TorbanP/lumenpnp/pnp/cad/STEP/x-gantry-back-BodyChamfer010.step

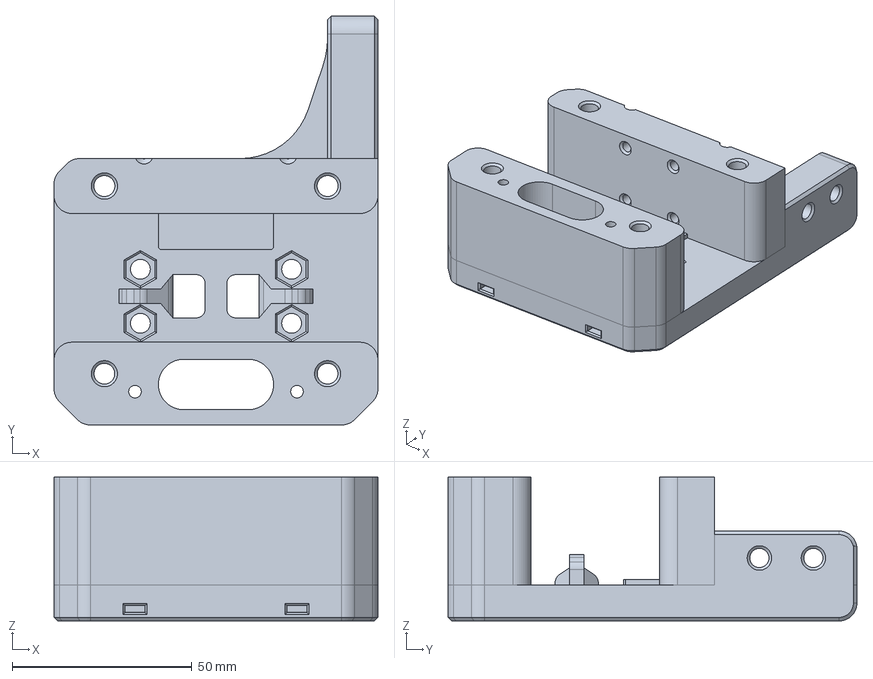
[picture p1: CAD file, 2023-11-08]
pnp/cad/STEP/x-gantry-back-BodyChamfer010.step
90.0 x 113.6 x 40.0 mm
