TorbanP/lumenpnp/pnp/cad/STEP/Feeder Rail.step

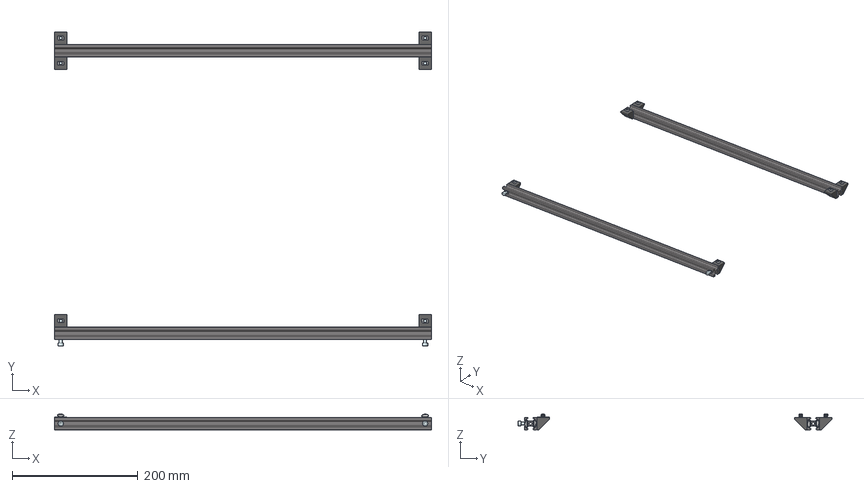
[picture p2: CAD file, 2023-11-08]
pnp/cad/STEP/Feeder Rail.step
600.1 x 500.5 x 25.1 mm
M5x8-Screw227
M5-tslot-nut028 x 2
vslot-extrusion-20mmx20mmx600mm004 x 2
M5x8-Screw186 x 2
M5-tslot-nut026 x 2
M5x8-Screw x 2
M5x8-Screw185 x 2
corner-bracket004 x 2
corner-bracket005 x 2
M5x8-Screw187 x 2
M5-tslot-nut027 x 2
M5-tslot-nut029 x 2
M5-tslot-nut006 x 2
M5-tslot-nut005 x 2
M5x10-Screw337 x 2
M5x10-Screw341 x 2
M5x8-Screw223
M5-tslot-nut019
M5x8-Screw225
corner-bracket003
corner-bracket001
corner-bracket
M5-tslot-nut024
M5-tslot-nut022
M5x8-Screw226
M5x8-Screw222
M5x8-Screw221
M5-tslot-nut025
M5-tslot-nut020
M5-tslot-nut018
corner-bracket002
M5x8-Screw224
M5x8-Screw220
M5-tslot-nut021
M5-tslot-nut023
vslot-extrusion-20mmx20mmx600mm006
