TorbanP/lumenpnp/(list of files, cad)

Other CAD files:
pnp/cad/STEP/Drag Chain/Drag Chain.iam
pnp/cad/STEP/Drag Chain/M5-Nut660.ipt
pnp/cad/STEP/Drag Chain/M5-Nut661.ipt
pnp/cad/STEP/Drag Chain/M5x10-Screw364.ipt
pnp/cad/STEP/Drag Chain/M5x10-Screw365.ipt
pnp/cad/STEP/Drag Chain/M5x16-Screw247.ipt
pnp/cad/STEP/Drag Chain/M5x16-Screw248.ipt
pnp/cad/STEP/Drag Chain/M5x25-Screw.ipt
pnp/cad/STEP/Drag Chain/drag-chain-asm.ipt
pnp/cad/STEP/Drag Chain/front-drag-chain-mount.ipt
pnp/cad/STEP/Drag Chain/x-cable-chain-bracket.ipt
pnp/cad/STEP/Feeder Rail/Feeder Rail.iam
pnp/cad/STEP/Feeder Rail/Front-Feeder-Rail.iam
pnp/cad/STEP/Feeder Rail/M5-tslot-nut005.ipt
pnp/cad/STEP/Feeder Rail/M5-tslot-nut006.ipt
pnp/cad/STEP/Feeder Rail/M5-tslot-nut018.ipt
pnp/cad/STEP/Feeder Rail/M5-tslot-nut019.ipt
pnp/cad/STEP/Feeder Rail/M5-tslot-nut020.ipt
pnp/cad/STEP/Feeder Rail/M5-tslot-nut021.ipt
pnp/cad/STEP/Feeder Rail/M5-tslot-nut022.ipt
pnp/cad/STEP/Feeder Rail/M5-tslot-nut023.ipt
pnp/cad/STEP/Feeder Rail/M5-tslot-nut024.ipt
pnp/cad/STEP/Feeder Rail/M5-tslot-nut025.ipt
pnp/cad/STEP/Feeder Rail/M5-tslot-nut026.ipt
pnp/cad/STEP/Feeder Rail/M5-tslot-nut027.ipt
pnp/cad/STEP/Feeder Rail/M5-tslot-nut028.ipt
pnp/cad/STEP/Feeder Rail/M5-tslot-nut029.ipt
pnp/cad/STEP/Feeder Rail/M5x10-Screw337.ipt
pnp/cad/STEP/Feeder Rail/M5x10-Screw341.ipt
pnp/cad/STEP/Feeder Rail/M5x8-Screw.ipt
pnp/cad/STEP/Feeder Rail/M5x8-Screw185.ipt
pnp/cad/STEP/Feeder Rail/M5x8-Screw186.ipt
pnp/cad/STEP/Feeder Rail/M5x8-Screw187.ipt
pnp/cad/STEP/Feeder Rail/M5x8-Screw220.ipt
pnp/cad/STEP/Feeder Rail/M5x8-Screw221.ipt
pnp/cad/STEP/Feeder Rail/M5x8-Screw222.ipt
pnp/cad/STEP/Feeder Rail/M5x8-Screw223.ipt
pnp/cad/STEP/Feeder Rail/M5x8-Screw224.ipt
pnp/cad/STEP/Feeder Rail/M5x8-Screw225.ipt
pnp/cad/STEP/Feeder Rail/M5x8-Screw226.ipt
pnp/cad/STEP/Feeder Rail/M5x8-Screw227.ipt
pnp/cad/STEP/Feeder Rail/corner-bracket.ipt
pnp/cad/STEP/Feeder Rail/corner-bracket001.ipt
pnp/cad/STEP/Feeder Rail/corner-bracket002.ipt
pnp/cad/STEP/Feeder Rail/corner-bracket003.ipt
pnp/cad/STEP/Feeder Rail/corner-bracket004.ipt
pnp/cad/STEP/Feeder Rail/corner-bracket005.ipt
pnp/cad/STEP/Feeder Rail/vslot-extrusion-20mmx20mmx600mm004.ipt
pnp/cad/STEP/Feeder Rail/vslot-extrusion-20mmx20mmx600mm006.ipt
pnp/cad/STEP/Staging Plate/Auxiliary-Staging-Plate.iam
pnp/cad/STEP/Staging Plate/M2.5x8-Screw197.ipt
pnp/cad/STEP/Staging Plate/M2.5x8-Screw198.ipt
pnp/cad/STEP/Staging Plate/M2.5x8-Screw199.ipt
pnp/cad/STEP/Staging Plate/M2.5x8-Screw200.ipt
pnp/cad/STEP/Staging Plate/M3-Nut543.ipt
pnp/cad/STEP/Staging Plate/M3-Nut544.ipt
pnp/cad/STEP/Staging Plate/M3-Nut545.ipt
pnp/cad/STEP/Staging Plate/M3-Nut546.ipt
pnp/cad/STEP/Staging Plate/M3-Nut551.ipt
pnp/cad/STEP/Staging Plate/M3-Nut552.ipt
pnp/cad/STEP/Staging Plate/M3-Nut553.ipt
pnp/cad/STEP/Staging Plate/M3-Nut554.ipt
pnp/cad/STEP/Staging Plate/M3-Nut556.ipt
pnp/cad/STEP/Staging Plate/M3-Nut557.ipt
pnp/cad/STEP/Staging Plate/M3-Nut558.ipt
pnp/cad/STEP/Staging Plate/M3-Nut560.ipt
pnp/cad/STEP/Staging Plate/M3-Nut561.ipt
pnp/cad/STEP/Staging Plate/M3-Nut565.ipt
pnp/cad/STEP/Staging Plate/M3-Nut566.ipt
pnp/cad/STEP/Staging Plate/M3-Nut567.ipt
pnp/cad/STEP/Staging Plate/M3-Nut568.ipt
pnp/cad/STEP/Staging Plate/M3-Nut580.ipt
pnp/cad/STEP/Staging Plate/M3-Nut581.ipt
pnp/cad/STEP/Staging Plate/M3-Nut582.ipt
pnp/cad/STEP/Staging Plate/M3-Nut583.ipt
pnp/cad/STEP/Staging Plate/M3-Nut584.ipt
pnp/cad/STEP/Staging Plate/M3-Nut585.ipt
pnp/cad/STEP/Staging Plate/M3-Nut594.ipt
pnp/cad/STEP/Staging Plate/M3-Nut675.ipt
pnp/cad/STEP/Staging Plate/M3-Nut807.ipt
pnp/cad/STEP/Staging Plate/M3-Nut808.ipt
pnp/cad/STEP/Staging Plate/M3x10-Screw.ipt
pnp/cad/STEP/Staging Plate/M3x10-Screw114.ipt
pnp/cad/STEP/Staging Plate/M3x10-Screw115.ipt
pnp/cad/STEP/Staging Plate/M3x10-Screw116.ipt
pnp/cad/STEP/Staging Plate/M3x10-Screw117.ipt
pnp/cad/STEP/Staging Plate/M3x10-Screw118.ipt
pnp/cad/STEP/Staging Plate/M3x10-Screw119.ipt
pnp/cad/STEP/Staging Plate/M3x10-Screw120.ipt
pnp/cad/STEP/Staging Plate/M3x10-Screw121.ipt
pnp/cad/STEP/Staging Plate/M3x10-Screw122.ipt
pnp/cad/STEP/Staging Plate/M3x10-Screw123.ipt
pnp/cad/STEP/Staging Plate/M3x10-Screw124.ipt
pnp/cad/STEP/Staging Plate/M3x10-Screw127.ipt
pnp/cad/STEP/Staging Plate/M3x10-Screw129.ipt
pnp/cad/STEP/Staging Plate/M3x14-Screw187.ipt
pnp/cad/STEP/Staging Plate/M3x14-Screw188.ipt
pnp/cad/STEP/Staging Plate/M3x14-Screw189.ipt
pnp/cad/STEP/Staging Plate/M3x14-Screw190.ipt
pnp/cad/STEP/Staging Plate/M3x14-Screw191.ipt
pnp/cad/STEP/Staging Plate/M3x14-Screw192.ipt
pnp/cad/STEP/Staging Plate/M3x14-Screw193.ipt
pnp/cad/STEP/Staging Plate/M3x16-Screw098.ipt
pnp/cad/STEP/Staging Plate/M3x16-Screw099.ipt
pnp/cad/STEP/Staging Plate/M3x16-Screw100.ipt
pnp/cad/STEP/Staging Plate/M3x16-Screw101.ipt
pnp/cad/STEP/Staging Plate/M3x16-Screw102.ipt
pnp/cad/STEP/Staging Plate/M3x16-Screw103.ipt
pnp/cad/STEP/Staging Plate/M3x16-Screw104.ipt
pnp/cad/STEP/Staging Plate/M3x16-Screw105.ipt
pnp/cad/STEP/Staging Plate/M3x30-Screw169.ipt
pnp/cad/STEP/Staging Plate/M3x30-Screw170.ipt
pnp/cad/STEP/Staging Plate/M3x30-Screw171.ipt
pnp/cad/STEP/Staging Plate/M3x5.5x25-Spacer.ipt
pnp/cad/STEP/Staging Plate/M3x5.5x25-Spacer004.ipt
pnp/cad/STEP/Staging Plate/M3x5.5x25-Spacer005.ipt
pnp/cad/STEP/Staging Plate/M3x5.5x25-Spacer006.ipt
pnp/cad/STEP/Staging Plate/M3x8-Screw541.ipt
pnp/cad/STEP/Staging Plate/M3x8-Screw542.ipt
pnp/cad/STEP/Staging Plate/M3x8-Screw543.ipt
pnp/cad/STEP/Staging Plate/M3x8-Screw544.ipt
pnp/cad/STEP/Staging Plate/M3x8-Screw545.ipt
pnp/cad/STEP/Staging Plate/M3x8-Screw546.ipt
pnp/cad/STEP/Staging Plate/M3x8-Screw547.ipt
pnp/cad/STEP/Staging Plate/M5-tslot-nut030.ipt
pnp/cad/STEP/Staging Plate/M5-tslot-nut031.ipt
pnp/cad/STEP/Staging Plate/M5-tslot-nut032.ipt
pnp/cad/STEP/Staging Plate/M5-tslot-nut033.ipt
pnp/cad/STEP/Staging Plate/M5-tslot-nut036.ipt
pnp/cad/STEP/Staging Plate/M5-tslot-nut037.ipt
pnp/cad/STEP/Staging Plate/M5-tslot-nut038.ipt
pnp/cad/STEP/Staging Plate/M5-tslot-nut039.ipt
pnp/cad/STEP/Staging Plate/M5x8-Screw228.ipt
pnp/cad/STEP/Staging Plate/M5x8-Screw229.ipt
pnp/cad/STEP/Staging Plate/M5x8-Screw230.ipt
pnp/cad/STEP/Staging Plate/M5x8-Screw231.ipt
pnp/cad/STEP/Staging Plate/M5x8-Screw232.ipt
pnp/cad/STEP/Staging Plate/M5x8-Screw233.ipt
pnp/cad/STEP/Staging Plate/M5x8-Screw234.ipt
pnp/cad/STEP/Staging Plate/M5x8-Screw235.ipt
pnp/cad/STEP/Staging Plate/Support-Foot.iam
pnp/cad/STEP/Staging Plate/Valves.iam
pnp/cad/STEP/Staging Plate/aux-staging-plate-foot.ipt
pnp/cad/STEP/Staging Plate/bottom-camera-cover.ipt
pnp/cad/STEP/Staging Plate/bottom-camera-mount.ipt
pnp/cad/STEP/Staging Plate/bottom-light-mount.ipt
pnp/cad/STEP/Staging Plate/bottom-ring-light.ipt
pnp/cad/STEP/Staging Plate/datum-board-mount.ipt
pnp/cad/STEP/Staging Plate/datum-board.ipt
pnp/cad/STEP/Staging Plate/mobo-bottom-cover.ipt
pnp/cad/STEP/Staging Plate/mobo-top-cover001.ipt
pnp/cad/STEP/Staging Plate/nozzle-rack.ipt
pnp/cad/STEP/Staging Plate/peek-cable-clamp.ipt
pnp/cad/STEP/Staging Plate/peek-cable-clamp001.ipt
pnp/cad/STEP/Staging Plate/peek-cable-clamp002.ipt
pnp/cad/STEP/Staging Plate/peek-cable-clamp003.ipt
pnp/cad/STEP/Staging Plate/peek-cable-clamp004.ipt
pnp/cad/STEP/Staging Plate/peek-cable-clamp005.ipt
pnp/cad/STEP/Staging Plate/pneumatic-y-adapter001.ipt
pnp/cad/STEP/Staging Plate/pneumatic-y-adapter002.ipt
pnp/cad/STEP/Staging Plate/pump-mount.ipt
pnp/cad/STEP/Staging Plate/pump-mount001.ipt
pnp/cad/STEP/Staging Plate/solenoid-valve.ipt
pnp/cad/STEP/Staging Plate/solenoid-valve001.ipt
pnp/cad/STEP/Staging Plate/staging-plate.ipt
pnp/cad/STEP/Staging Plate/staging-plate1.ipt
pnp/cad/STEP/Staging Plate/static-camera-foot.ipt
pnp/cad/STEP/Staging Plate/usb-camera-lower.ipt
pnp/cad/STEP/Staging Plate/vacuum-pump.ipt
pnp/cad/STEP/Staging Plate/vacuum-pump001.ipt
pnp/cad/STEP/Staging Plate/valve-mount.ipt
pnp/cad/STEP/Staging Plate/y-coupler-bracket.ipt
pnp/cad/STEP/X-Gantry Back/525mm-MGN12H.ipt
pnp/cad/STEP/X-Gantry Back/Array004.iam
pnp/cad/STEP/X-Gantry Back/CameraAndLight.iam
pnp/cad/STEP/X-Gantry Back/GT2-idler005.ipt
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
