TorbanP/lumenpnp/pnp/pcb/mobo/dual_motors.kicad_sch

## KiCad design pnp/pcb/mobo/dual_motors.kicad_sch (2023-09-23)

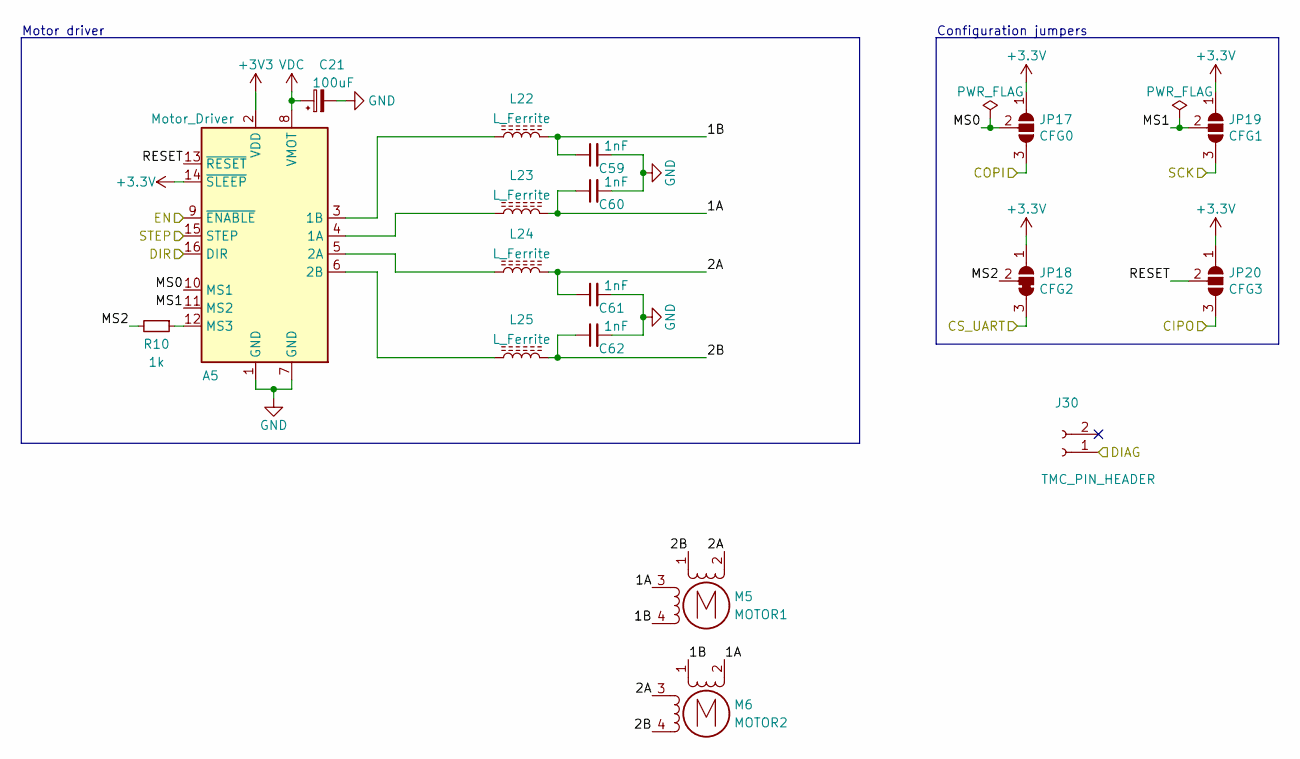
[picture p4: schematic dual_motors.kicad_sch]

Parts:
A5: Motor_Driver; Pololu_Breakout-16_15.2x20.3mm; Digikey 1460-TMC2209SILENTSTEPSTICK-ND
C21: 100uF; CP_Elec_6.3x7.7; Digikey 493-2203-1-ND
C59, C60, C61, C62: 1nF; C_0805_2012Metric; Digikey 1276-1020-1-ND
J30: TMC_PIN_HEADER; PinSocket_1x02_P2.54mm_Vertical; LCSC C49661
JP17: CFG0; SolderJumper-3_P1.3mm_Open_RoundedPad1.0x1.5mm; LCSC DNP
JP18: CFG2; SolderJumper-3_P1.3mm_Bridged23_RoundedPad1.0x1.5mm; LCSC DNP
JP19: CFG1; SolderJumper-3_P1.3mm_Open_RoundedPad1.0x1.5mm; LCSC DNP
JP20: CFG3; SolderJumper-3_P1.3mm_Open_RoundedPad1.0x1.5mm; LCSC DNP
L22, L23, L24, L25: L_Ferrite; L_0805_2012Metric; Digikey 1934-1472-1-ND
M5: MOTOR1; JST_XH_B4B-XH-A_1x04_P2.50mm_Vertical; LCSC C37815
M6: MOTOR2; JST_XH_B4B-XH-A_1x04_P2.50mm_Vertical; LCSC C37815
R10: 1k; R_0805_2012Metric; JLCPCB C17513

Connections:
1A: C60.1, L23.2, M5.3, M6.2 (-)
1B: C59.1, L22.2, M5.4, M6.1
2A: C61.1, L24.2, M5.2 (-), M6.3
2B: C62.1, L25.2, M5.1, M6.4
+3.3V: A5.14 (~SLEEP), JP17.1 (A), JP18.1 (B), JP19.1 (A), JP20.1 (A)
+3V3: A5.2 (VDD)
CIPO: JP20.3 (B)
COPI: JP17.3 (B)
CS_UART: JP18.3 (A)
DIAG: J30.1
DIR: A5.16 (DIR)
EN: A5.9 (~ENABLE)
GND: A5.1 (GND), A5.7 (GND), C21.2, C59.2, C60.2, C61.2, C62.2
MS0: A5.10 (MS1), JP17.2 (C)
MS1: A5.11 (MS2), JP19.2 (C)
MS2: JP18.2 (C), R10.2
unnamed: A5.3 (1B), L22.1
unnamed: A5.4 (1A), L23.1
unnamed: A5.5 (2A), L24.1
unnamed: A5.6 (2B), L25.1
unnamed: A5.12 (MS3), R10.1
RESET: A5.13 (~RESET), JP20.2 (C)
SCK: JP19.3 (B)
STEP: A5.15 (STEP)
VDC: A5.8 (VMOT), C21.1

Notes on the sheet:
Configuration jumpers
Motor driver
