TorbanP/lumenpnp/pnp/pcb/mobo/limit_switches.kicad_sch

## KiCad design pnp/pcb/mobo/limit_switches.kicad_sch (2023-09-23)

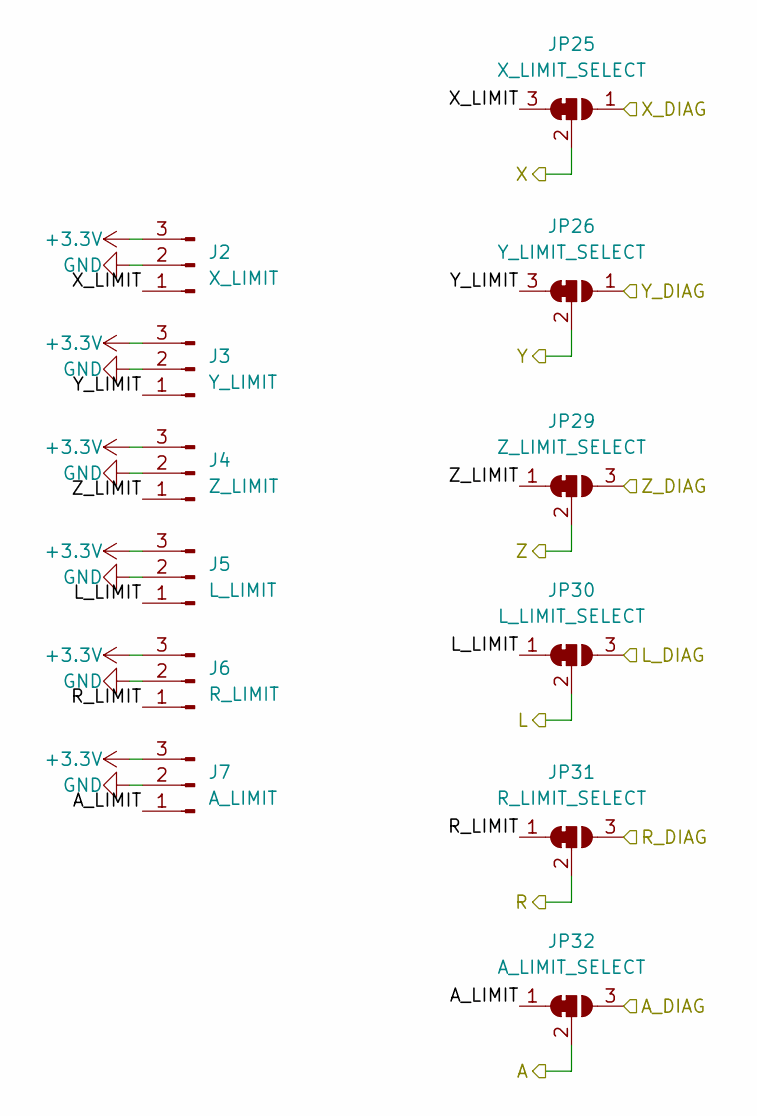
[picture p5: schematic limit_switches.kicad_sch]

Parts:
J2: X_LIMIT; JST_XH_B3B-XH-A_1x03_P2.50mm_Vertical; LCSC C2316
J3: Y_LIMIT; JST_XH_B3B-XH-A_1x03_P2.50mm_Vertical; LCSC C2316
J4: Z_LIMIT; JST_XH_B3B-XH-A_1x03_P2.50mm_Vertical; LCSC C2316
J5: L_LIMIT; JST_XH_B3B-XH-A_1x03_P2.50mm_Vertical; LCSC C2316
J6: R_LIMIT; JST_XH_B3B-XH-A_1x03_P2.50mm_Vertical; LCSC C2316
J7: A_LIMIT; JST_XH_B3B-XH-A_1x03_P2.50mm_Vertical; LCSC C2316
JP25: X_LIMIT_SELECT; SolderJumper-3_P1.3mm_Bridged12_RoundedPad1.0x1.5mm; LCSC DNP
JP26: Y_LIMIT_SELECT; SolderJumper-3_P1.3mm_Bridged12_RoundedPad1.0x1.5mm; LCSC DNP
JP29: Z_LIMIT_SELECT; SolderJumper-3_P1.3mm_Bridged12_RoundedPad1.0x1.5mm; LCSC DNP
JP30: L_LIMIT_SELECT; SolderJumper-3_P1.3mm_Bridged12_RoundedPad1.0x1.5mm; LCSC DNP
JP31: R_LIMIT_SELECT; SolderJumper-3_P1.3mm_Bridged12_RoundedPad1.0x1.5mm; LCSC DNP
JP32: A_LIMIT_SELECT; SolderJumper-3_P1.3mm_Bridged12_RoundedPad1.0x1.5mm; LCSC DNP

Connections:
+3.3V: J2.3, J3.3, J4.3, J5.3, J6.3, J7.3
A: JP32.2 (C)
A_DIAG: JP32.3 (B)
A_LIMIT: J7.1, JP32.1 (A)
GND: J2.2, J3.2, J4.2, J5.2, J6.2, J7.2
L: JP30.2 (C)
L_DIAG: JP30.3 (B)
L_LIMIT: J5.1, JP30.1 (A)
R: JP31.2 (C)
R_DIAG: JP31.3 (B)
R_LIMIT: J6.1, JP31.1 (A)
X: JP25.2 (C)
X_DIAG: JP25.1 (B)
X_LIMIT: J2.1, JP25.3 (A)
Y: JP26.2 (C)
Y_DIAG: JP26.1 (B)
Y_LIMIT: J3.1, JP26.3 (A)
Z: JP29.2 (C)
Z_DIAG: JP29.3 (B)
Z_LIMIT: J4.1, JP29.1 (A)
