TorbanP/lumenpnp/pnp/pcb/mobo/servos.kicad_sch

## KiCad design pnp/pcb/mobo/servos.kicad_sch (2023-09-23)

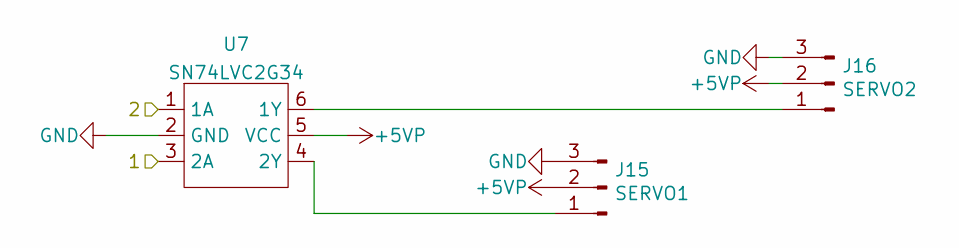
[picture p10: schematic servos.kicad_sch]

Parts:
J15: SERVO1; JST_XH_B3B-XH-A_1x03_P2.50mm_Vertical; LCSC C2316
J16: SERVO2; JST_XH_B3B-XH-A_1x03_P2.50mm_Vertical; LCSC C2316
U7: SN74LVC2G34; SOT-23-6; Digikey SN74LVC2G34DBVR

Connections:
1: U7.3 (2A)
2: U7.1 (1A)
+5VP: J15.2, J16.2, U7.5 (VCC)
GND: J15.3, J16.3, U7.2 (GND)
unnamed: J15.1, U7.4 (2Y)
unnamed: J16.1, U7.6 (1Y)
