TorbanP/lumenpnp/pnp/pcb/mobo/usb.kicad_sch

## KiCad design pnp/pcb/mobo/usb.kicad_sch (2023-09-23)

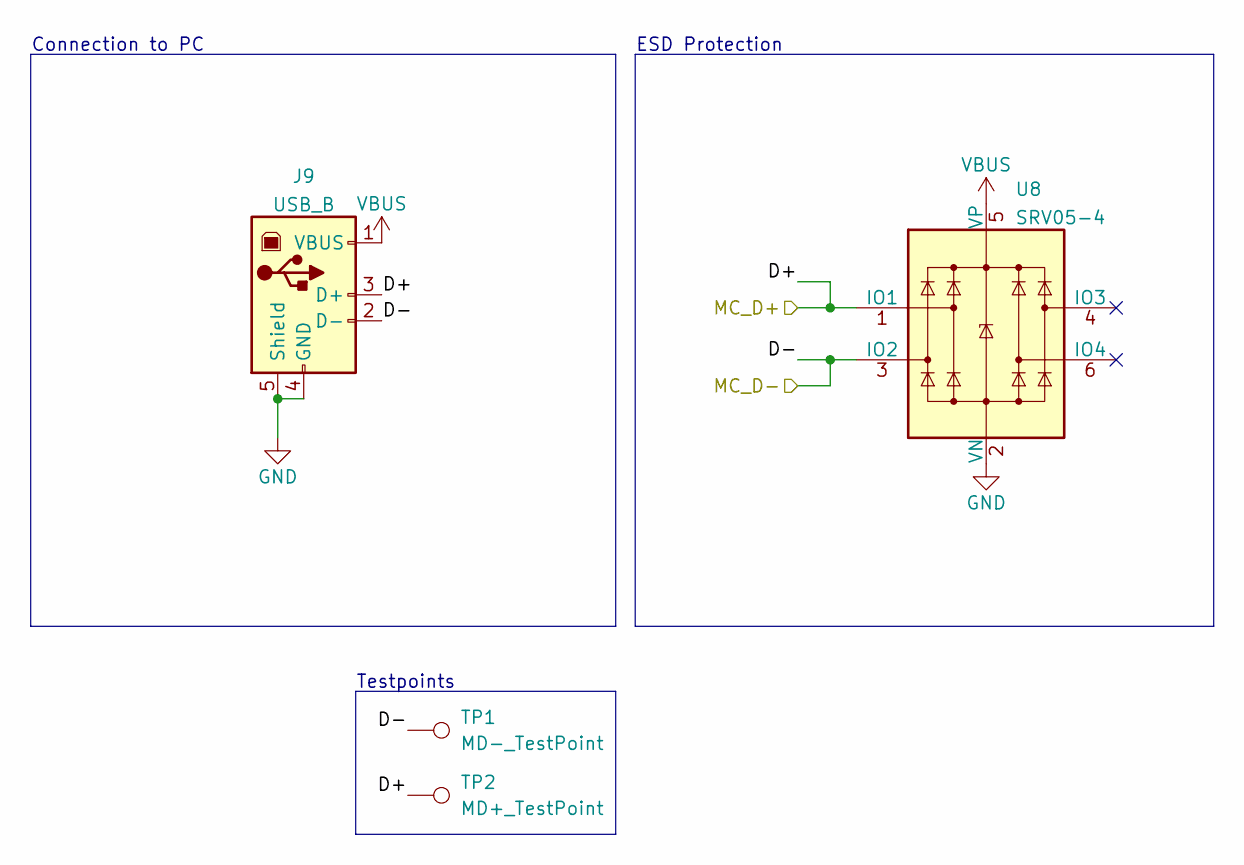
[picture p12: schematic usb.kicad_sch]

Parts:
J9: USB_B; USB_B_Lumberg_2411_02_Horizontal; Digikey SS-52300-001
TP1: MD-_TestPoint; TestPoint_Pad_D2.0mm; LCSC DNP
TP2: MD+_TestPoint; TestPoint_Pad_D2.0mm; LCSC DNP
U8: SRV05-4; SOT-23-6; Digikey 4617-SRV05-4TR-ND

Connections:
D+: J9.3 (D+), TP2.1, U8.1 (IO1)
D-: J9.2 (D-), TP1.1, U8.3 (IO2)
GND: J9.4 (GND), J9.5 (Shield), U8.2 (VN)
VBUS: J9.1 (VBUS), U8.5 (VP)

Notes on the sheet:
ESD Protection
Testpoints
Connection to PC
