TorbanP/lumenpnp/pnp/pcb/mobo/vacuum_sensors.kicad_sch

## KiCad design pnp/pcb/mobo/vacuum_sensors.kicad_sch (2023-09-23)

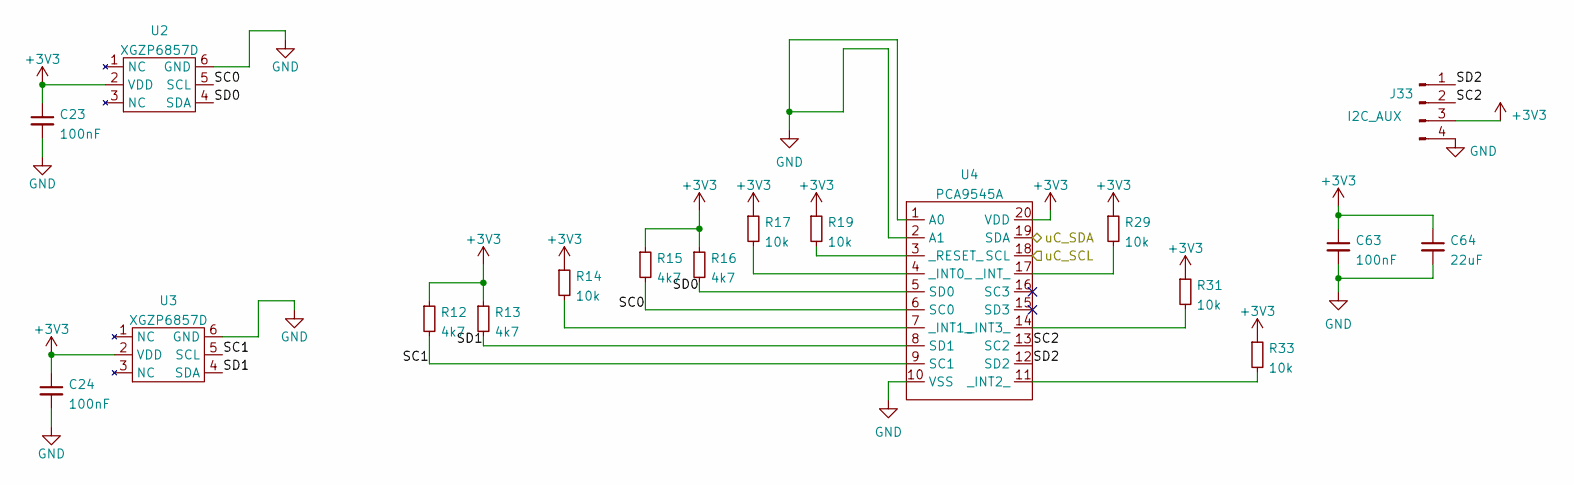
[picture p13: schematic vacuum_sensors.kicad_sch]

Parts:
C23, C24, C63: 100nF; C_0805_2012Metric; Digikey 1276-1180-1-ND
C64: 22uF; C_0805_2012Metric; JLCPCB C45783
J33: I2C_AUX; PinHeader_1x04_P2.54mm_Vertical; LCSC C2691448
R12, R13, R15, R16: 4k7; R_0805_2012Metric; Digikey A129757CT-ND
R14, R17, R19, R29, R31, R33: 10k; R_0805_2012Metric; Digikey RMCF0805FT10K0CT-ND
U2, U3: XGZP6857D; LCSC DNP
U4: PCA9545A; TSSOP-20_4.4x6.5mm_P0.65mm; Digikey 568-1865-1-ND

Connections:
+3V3: C23.1, C24.1, C63.1, C64.1, J33.3, R12.1, R13.1, R14.1, R15.1, R16.1, R17.1, R19.1, R29.1, R31.1, R33.1, U2.2 (VDD), U3.2 (VDD), U4.20 (VDD)
GND: C23.2, C24.2, C63.2, C64.2, J33.4, U2.6 (GND), U3.6 (GND), U4.1 (A0), U4.2 (A1), U4.10 (VSS)
unnamed: R14.2, U4.7 (_INT1_)
unnamed: R17.2, U4.4 (_INT0_)
unnamed: R19.2, U4.3 (_RESET_)
unnamed: R29.2, U4.17 (_INT_)
unnamed: R31.2, U4.14 (_INT3_)
unnamed: R33.2, U4.11 (_INT2_)
SC0: R15.2, U2.5 (SCL), U4.6 (SC0)
SC1: R12.2, U3.5 (SCL), U4.9 (SC1)
SC2: J33.2, U4.13 (SC2)
SD0: R16.2, U2.4 (SDA), U4.5 (SD0)
SD1: R13.2, U3.4 (SDA), U4.8 (SD1)
SD2: J33.1, U4.12 (SD2)
uC_SCL: U4.18 (SCL)
uC_SDA: U4.19 (SDA)
