TorbanP/lumenpnp/(commit log)

2023-09-23 tweak PN of mobo
    [RS485.kicad_sch, dual_motors.kicad_sch, limit_switches.kicad_sch, microcontroller.kicad_sch, miscellaneous.kicad_sch, mosfet.kicad_sch, power.kicad_sch, servos.kicad_sch]
2023-11-08 step export & inventor assy
    [525mm-MGN12H.ipt, 550mm-MGN12H001_001.ipt, 550mm-MGN12H001_002.ipt, Array.iam, Array002.iam, Array004.iam, Auxiliary-Staging-Plate.iam, Back-Left-Leg-Extension.iam]
